Freems88/esp32-eink-clock/Counting_Seconds.ino

#include "secrets.h"
#include "bitmaps.h"
#include "weather_icons.h"
#include <GxEPD2_BW.h>
#include <U8g2_for_Adafruit_GFX.h>
#include <WiFi.h>
#include <HTTPClient.h>
#include <ArduinoJson.h>
#include <time.h>
#include <SPI.h>
#include <driver/gpio.h>

// ── Display definitions ────────────────────────────────────────────────────
// Board: FireBeetle 2 ESP32-C5 (DFR1222) — see MIGRATION.md
// Shared SPI: SCK=23, MOSI=24 (hardware SPI), DC=10, RST=9
//
// Every panel gets a real BUSY line. GPIO11/12 are free because the C5 uses
// native USB CDC for Serial (UART0 unused); GPIO25/MISO is free because e-ink
// is write-only. GPIO7 and 25 are strapping pins but NOT boot-mode ones (only
// 26/27/28 set boot mode) — and BUSY is an input, so we never drive them.
// They're assigned to DD and MMM, the two panels that refresh least often.
//
//                                  CS   BUSY   BUSY silkscreen
// display1 = 4"   MM (minutes)      8     6     6/D12/LP_SDA
// display2 = 4"   HH (hours)        5    11     11/TX
// display3 = 4"   DD (day)          4    25     25/MI   (strapping, SDIO)
// display4 = 4"   MMM (month)       3     7     7/D11/LP_SCL (strapping)
// display5 = 7"   DDDE / weather    2    12     12/RX
//
// Left alone: 15 (onboard LED), 1 (battery ADC), 26/27/28 (boot-mode strapping)

const int PIN_SCK  = 23;
const int PIN_MOSI = 24;
// GPIO25 is the board's MISO but e-ink never reads back, so it serves as display3 BUSY

GxEPD2_BW<GxEPD2_420_GDEY042T81, GxEPD2_420_GDEY042T81::HEIGHT / 4> display1(GxEPD2_420_GDEY042T81(/*CS=*/ 8, /*DC=*/ 10, /*RST=*/ 9, /*BUSY=*/ 6));
GxEPD2_BW<GxEPD2_420_GDEY042T81, GxEPD2_420_GDEY042T81::HEIGHT / 4> display2(GxEPD2_420_GDEY042T81(/*CS=*/ 5, /*DC=*/ 10, /*RST=*/ 9, /*BUSY=*/ 11));
GxEPD2_BW<GxEPD2_420_GDEY042T81, GxEPD2_420_GDEY042T81::HEIGHT / 4> display3(GxEPD2_420_GDEY042T81(/*CS=*/ 4, /*DC=*/ 10, /*RST=*/ 9, /*BUSY=*/ 25));
GxEPD2_BW<GxEPD2_420_GDEY042T81, GxEPD2_420_GDEY042T81::HEIGHT / 4> display4(GxEPD2_420_GDEY042T81(/*CS=*/ 3, /*DC=*/ 10, /*RST=*/ 9, /*BUSY=*/ 7));
GxEPD2_BW<GxEPD2_750_GDEY075T7, GxEPD2_750_GDEY075T7::HEIGHT / 2>  display5(GxEPD2_750_GDEY075T7( /*CS=*/ 2, /*DC=*/ 10, /*RST=*/ 9, /*BUSY=*/ 12));

U8G2_FOR_ADAFRUIT_GFX u8g2Fonts;

const char* ssid     = WIFI_SSID;
const char* password = WIFI_PASSWORD;

// ── Weather helpers ────────────────────────────────────────────────────────

const char* weatherDescription(int code)
{
  if (code == 0)  return "Clear";
  if (code <= 3)  return "Partly Cloudy";
  if (code <= 48) return "Foggy";
  if (code <= 55) return "Drizzle";
  if (code <= 67) return "Rain";
  if (code <= 77) return "Snow";
  if (code <= 82) return "Showers";
  if (code <= 99) return "Thunderstorm";
  return "Unknown";
}

const char* windCardinal(int degrees)
{
  const char* directions[] = {
    "N","NNE","NE","ENE","E","ESE","SE","SSE",
    "S","SSW","SW","WSW","W","WNW","NW","NNW"
  };
  return directions[(int)((degrees + 11.25) / 22.5) % 16];
}

// ── Location (defined in secrets.h) ────────────────────────────────────────

const float LAT = WEATHER_LAT;
const float LON = WEATHER_LON;

// ── Bitmap dimensions ──────────────────────────────────────────────────────
// Digit bitmaps (display1, display2): two per panel side by side
const int DIGIT_BITMAP_WIDTH  = 200;
const int DIGIT_BITMAP_HEIGHT = 300;

// Day-of-week bitmaps (display5 upper half): full 7" panel width
const int DOW_BITMAP_WIDTH  = 800;
const int DOW_BITMAP_HEIGHT = 240;

// Month bitmaps (display4): full 4.2" panel width
const int MONTH_BITMAP_WIDTH  = 400;
const int MONTH_BITMAP_HEIGHT = 300;

// ── RTC memory (survives light sleep) ─────────────────────────────────────

RTC_DATA_ATTR int  lastMinute        = -1;
RTC_DATA_ATTR int  lastHour          = -1;
RTC_DATA_ATTR int  lastDay           = -1;
RTC_DATA_ATTR int  lastMonth         = -1;
RTC_DATA_ATTR int  lastSyncSlot      = -1;
RTC_DATA_ATTR int  updateCount       = 0;
RTC_DATA_ATTR bool lastWeatherValid  = false;
RTC_DATA_ATTR bool weatherChanged    = false;  // set after each sync, cleared after full refresh
RTC_DATA_ATTR bool batteryShutdown   = false;  // parked on low battery, waiting for charge
RTC_DATA_ATTR int    weatherRetriesLeft = 0;   // bounded next-minute retries after a failed fetch
RTC_DATA_ATTR time_t lastWeatherSync    = 0;   // when the last successful fetch happened

// Keep showing stale weather for up to 2h before declaring it unavailable
const time_t WEATHER_STALE_SECS = 2 * 3600;

RTC_DATA_ATTR int   weatherCode      = 0;
RTC_DATA_ATTR float rainSum          = 0;
RTC_DATA_ATTR float showersSum       = 0;
RTC_DATA_ATTR float snowfallSum      = 0;
RTC_DATA_ATTR float currentTemp      = 0;
RTC_DATA_ATTR float feelsLike        = 0;
RTC_DATA_ATTR float humidity         = 0;
RTC_DATA_ATTR float windSpeed        = 0;
RTC_DATA_ATTR int   windDirection    = 0;
RTC_DATA_ATTR float precipitation24h = 0;
RTC_DATA_ATTR float dayHigh          = 0;
RTC_DATA_ATTR float dayLow           = 0;
RTC_DATA_ATTR bool  weatherValid     = false;
RTC_DATA_ATTR bool  timeValid        = true;
RTC_DATA_ATTR char  weatherError[48] = "no attempt";
RTC_DATA_ATTR float pressure         = 0;
RTC_DATA_ATTR char  sunriseStr[6]    = "--:--";
RTC_DATA_ATTR char  sunsetStr[6]     = "--:--";

// ── Lookup tables ──────────────────────────────────────────────────────────

const char* dayNames[] = {
  "SUNDAY","MONDAY","TUESDAY","WEDNESDAY",
  "THURSDAY","FRIDAY","SATURDAY"
};

const char* monthNames[] = {
  "JAN","FEB","MAR","APR","MAY","JUN",
  "JUL","AUG","SEP","OCT","NOV","DEC"
};

const unsigned char* monthBitmaps[] = {
  epd_bitmap_VerdanaJAN, epd_bitmap_VerdanaFEB, epd_bitmap_VerdanaMAR,
  epd_bitmap_VerdanaAPR, epd_bitmap_VerdanaMAY, epd_bitmap_VerdanaJUN,
  epd_bitmap_VerdanaJUL, epd_bitmap_VerdanaAUG, epd_bitmap_VerdanaSEP,
  epd_bitmap_VerdanaOCT, epd_bitmap_VerdanaNOV, epd_bitmap_VerdanaDEC
};

// ── Day-of-week bitmap index ───────────────────────────────────────────────
// bitmaps.h allArray index by tm_wday (alphabetical order in new file):
// 14=FRI, 20=MON, 23=SAT, 25=SUN, 26=THURS, 27=TUES, 28=WED

int dowBitmapIndex(int tm_wday)
{
  const int indices[7] = {25, 20, 27, 28, 26, 14, 23}; // Sun=0 … Sat=6
  return indices[tm_wday];
}

// ── WiFi / NTP / Weather ───────────────────────────────────────────────────

bool fetchWeather()
{
  HTTPClient http;
  String url = String("https://api.open-meteo.com/v1/forecast?") +
    "latitude="  + String(LAT, 4) +
    "&longitude=" + String(LON, 4) +
    "&current=temperature_2m,apparent_temperature,relative_humidity_2m,"
               "wind_speed_10m,wind_direction_10m,weather_code,surface_pressure" +
    "&daily=temperature_2m_max,temperature_2m_min,precipitation_sum,"
            "rain_sum,showers_sum,snowfall_sum,sunrise,sunset" +
    "&timezone=auto&forecast_days=1";  // auto resolves tz from the coordinates

  http.begin(url);
  http.setTimeout(15000);  // TLS handshake can be slow; 8s was causing HTTP -1
  int httpCode = http.GET();
  if (httpCode != 200)
  {
    snprintf(weatherError, sizeof(weatherError), "HTTP %d  WiFi:%d", httpCode, WiFi.status());
    Serial.printf("Weather HTTP error: %d\n", httpCode);
    http.end();
    return false;
  }

  String payload = http.getString();
  http.end();

  DynamicJsonDocument doc(2048);
  if (deserializeJson(doc, payload))
  {
    snprintf(weatherError, sizeof(weatherError), "JSON parse  WiFi:%d", WiFi.status());
    Serial.println("JSON parse failed");
    return false;
  }

  currentTemp      = doc["current"]["temperature_2m"];
  feelsLike        = doc["current"]["apparent_temperature"];
  humidity         = doc["current"]["relative_humidity_2m"];
  windSpeed        = doc["current"]["wind_speed_10m"];
  windDirection    = doc["current"]["wind_direction_10m"];
  weatherCode      = doc["current"]["weather_code"];
  pressure         = doc["current"]["surface_pressure"];
  dayHigh          = doc["daily"]["temperature_2m_max"][0];
  dayLow           = doc["daily"]["temperature_2m_min"][0];
  precipitation24h = doc["daily"]["precipitation_sum"][0];
  rainSum          = doc["daily"]["rain_sum"][0];
  showersSum       = doc["daily"]["showers_sum"][0];
  snowfallSum      = doc["daily"]["snowfall_sum"][0];

  // Parse sunrise/sunset — Open-Meteo returns "YYYY-MM-DDTHH:MM", keep HH:MM
  const char* sr = doc["daily"]["sunrise"][0];
  const char* ss = doc["daily"]["sunset"][0];
  if (sr && strlen(sr) >= 16) strncpy(sunriseStr, sr + 11, 5), sunriseStr[5] = '\0';
  if (ss && strlen(ss) >= 16) strncpy(sunsetStr,  ss + 11, 5), sunsetStr[5]  = '\0';

  return true;
}

void showError(const char* msg)
{
  // display6 retired — errors logged to Serial only
  Serial.printf("ERROR: %s\n", msg);
}

bool connectSyncAndFetch()
{
  WiFi.mode(WIFI_STA);
  WiFi.begin(ssid, password);
  int attempts = 0;
  // Wait for association AND a valid DHCP address (not just layer-2 link)
  while (attempts < 20 &&
         (WiFi.status() != WL_CONNECTED ||
          WiFi.localIP() == IPAddress(0, 0, 0, 0)))
  {
    delay(500);
    attempts++;
  }
  Serial.printf("WiFi up after %d attempts, IP: %s\n",
                attempts, WiFi.localIP().toString().c_str());

  if (WiFi.status() != WL_CONNECTED)
  {
    String reason = "wifi failed: ";
    switch (WiFi.status())
    {
      case WL_NO_SSID_AVAIL:  reason += "no network found"; break;
      case WL_CONNECT_FAILED: reason += "wrong password";   break;
      case WL_DISCONNECTED:   reason += "disconnected";     break;
      default:                reason += String(WiFi.status()); break;
    }
    WiFi.disconnect(true);
    WiFi.mode(WIFI_OFF);
    showError(reason.c_str());
    return false;
  }

  // configTzTime (not configTime) — plain configTime(0,0,...) overwrites TZ with UTC
  configTzTime(CLOCK_TZ, "time.google.com", "time.cloudflare.com", "pool.ntp.org");

  struct tm timeinfo;
  int ntpAttempts = 0;
  while (!getLocalTime(&timeinfo) && ntpAttempts < 5)
  {
    ntpAttempts++;
    Serial.printf("NTP attempt %d of 5\n", ntpAttempts);
    showError(("NTP sync " + String(ntpAttempts) + "/5").c_str());
    delay(2000);
  }

  if (!getLocalTime(&timeinfo))
  {
    timeValid = false;
    showError("NTP failed");
  }
  else
  {
    timeValid = true;
    Serial.printf("Synced to: %02d:%02d:%02d\n",
      timeinfo.tm_hour, timeinfo.tm_min, timeinfo.tm_sec);
  }

  bool fetched = false;
  for (int attempt = 1; attempt <= 3 && !fetched; attempt++)
  {
    fetched = fetchWeather();
    if (!fetched)
    {
      Serial.printf("Weather fetch failed (attempt %d/3)\n", attempt);
      if (attempt < 3) delay(2000 * attempt);  // 2s then 4s backoff
    }
  }
  if (fetched)
  {
    weatherValid    = true;
    lastWeatherSync = time(nullptr);
  }
  else if (weatherValid && time(nullptr) - lastWeatherSync > WEATHER_STALE_SECS)
  {
    // On failure, keep showing the last good data; only surface
    // "Weather unavailable" once it has gone truly stale
    weatherValid = false;
  }

  WiFi.disconnect(true);
  WiFi.mode(WIFI_OFF);
  Serial.println("WiFi off");
  return true;
}

// ── Display rendering ──────────────────────────────────────────────────────

// Display 2 (right): HH — hours in 12hr format, two digit bitmaps side by side
void showHH(struct tm timeinfo, bool fullRefresh)
{
  int hour12 = timeinfo.tm_hour % 12;
  if (hour12 == 0) hour12 = 12;

  display2.setRotation(0);
  if (fullRefresh) { display2.clearScreen(); display2.setFullWindow(); }
  else display2.setPartialWindow(0, 0, display2.width(), display2.height());

  display2.firstPage();
  do
  {
    display2.fillScreen(GxEPD_WHITE);
    display2.drawBitmap(0, 0,
      epd_bitmap_allArray[hour12 / 10],
      DIGIT_BITMAP_WIDTH, DIGIT_BITMAP_HEIGHT, GxEPD_BLACK);
    display2.drawBitmap(DIGIT_BITMAP_WIDTH, 0,
      epd_bitmap_allArray[hour12 % 10],
      DIGIT_BITMAP_WIDTH, DIGIT_BITMAP_HEIGHT, GxEPD_BLACK);
  }
  while (display2.nextPage());
}

// Display 1 (left): MM — minutes, two digit bitmaps side by side
// AM/PM overlaid in the lower-right corner (negative space of units digit)
void showMM(struct tm timeinfo, bool fullRefresh)
{
  const char* ampm = timeinfo.tm_hour < 12 ? "AM" : "PM";

  display1.setRotation(0);
  if (fullRefresh) { display1.clearScreen(); display1.setFullWindow(); }
  else display1.setPartialWindow(0, 0, display1.width(), display1.height());

  // measure AM/PM text width before entering the loop
  u8g2Fonts.begin(display1);
  u8g2Fonts.setFontMode(1);
  u8g2Fonts.setFont(u8g2_font_fub30_tf);
  int16_t ampmW = u8g2Fonts.getUTF8Width(ampm);
  int16_t ampmX = display1.width() - ampmW - 16;
  int16_t ampmY = display1.height() - 16;

  display1.firstPage();
  do
  {
    display1.fillScreen(GxEPD_WHITE);
    display1.drawBitmap(0, 0,
      epd_bitmap_allArray[timeinfo.tm_min / 10],
      DIGIT_BITMAP_WIDTH, DIGIT_BITMAP_HEIGHT, GxEPD_BLACK);
    display1.drawBitmap(DIGIT_BITMAP_WIDTH, 0,
      epd_bitmap_allArray[timeinfo.tm_min % 10],
      DIGIT_BITMAP_WIDTH, DIGIT_BITMAP_HEIGHT, GxEPD_BLACK);

    // bind u8g2 AFTER drawBitmap calls — avoids GFX state reset
    u8g2Fonts.begin(display1);
    u8g2Fonts.setFontMode(1);
    u8g2Fonts.setFont(u8g2_font_fub30_tf);
    u8g2Fonts.setForegroundColor(GxEPD_WHITE);
    u8g2Fonts.setBackgroundColor(GxEPD_BLACK);

    u8g2Fonts.setCursor(ampmX, ampmY);
    u8g2Fonts.print(ampm);
  }
  while (display1.nextPage());
}

// Maps WMO weather code + hour to weatherIcons[] index
// 0=clear day, 1=clear night, 2=clouds, 3=rain, 4=thunderstorm, 5=snow, 6=mist
int weatherIconIndex(int code, int hour)
{
  bool isDay = (hour >= 6 && hour < 20);
  if (code == 0)              return isDay ? 0 : 1;
  if (code <= 3)              return 2;
  if (code <= 48)             return 6;
  if (code <= 67 || (code >= 80 && code <= 82)) return 3;
  if (code <= 77 || (code >= 85 && code <= 86)) return 5;
  return 4;  // thunderstorm
}

// Nearest-neighbor scaled bitmap draw for display5 (white pixels on black bg)
static void drawScaledIcon(int x, int y, const uint8_t* bmp, int dstW, int dstH)
{
  for (int dy = 0; dy < dstH; dy++) {
    int sy = dy * 128 / dstH;
    for (int dx = 0; dx < dstW; dx++) {
      int sx = dx * 128 / dstW;
      int bit = sy * 128 + sx;
      if (pgm_read_byte(bmp + bit / 8) & (0x80 >> (bit % 8)))
        display5.drawPixel(x + dx, y + dy, GxEPD_WHITE);
    }
  }
}


// Teardrop water-drop icon, tip pointing up, circle centre at (cx, cy)
static void drawWaterDrop(int cx, int cy, int r)
{
  display5.fillCircle(cx, cy, r, GxEPD_WHITE);
  display5.fillTriangle(cx, cy - r - r, cx - r, cy, cx + r, cy, GxEPD_WHITE);
}

// Display 3: DD — day of month with leading zero, two digit bitmaps side by side
void showDD(struct tm timeinfo, bool fullRefresh)
{
  int day = timeinfo.tm_mday;  // 1–31; leading-zero handled by integer split

  display3.setRotation(0);
  if (fullRefresh) { display3.clearScreen(); display3.setFullWindow(); }
  else display3.setPartialWindow(0, 0, display3.width(), display3.height());

  display3.firstPage();
  do
  {
    display3.fillScreen(GxEPD_WHITE);
    display3.drawBitmap(0, 0,
      epd_bitmap_allArray[day / 10],
      DIGIT_BITMAP_WIDTH, DIGIT_BITMAP_HEIGHT, GxEPD_BLACK);
    display3.drawBitmap(DIGIT_BITMAP_WIDTH, 0,
      epd_bitmap_allArray[day % 10],
      DIGIT_BITMAP_WIDTH, DIGIT_BITMAP_HEIGHT, GxEPD_BLACK);
  }
  while (display3.nextPage());
}

// Display 4: MMM — full-panel month bitmap (400×300), same pattern as digit displays
void showMMM(struct tm timeinfo, bool fullRefresh)
{
  display4.setRotation(0);
  if (fullRefresh) { display4.clearScreen(); display4.setFullWindow(); }
  else display4.setPartialWindow(0, 0, display4.width(), display4.height());

  display4.firstPage();
  do
  {
    display4.fillScreen(GxEPD_WHITE);
    display4.drawBitmap(0, 0,
      monthBitmaps[timeinfo.tm_mon],
      MONTH_BITMAP_WIDTH, MONTH_BITMAP_HEIGHT, GxEPD_BLACK);
  }
  while (display4.nextPage());
}

// Battery voltage on GPIO1. analogReadMilliVolts applies the chip's factory ADC
// calibration — much more accurate than converting raw counts by hand.
// Divider measured at 2.015 (multimeter 3.96V vs 1.965V at the ADC); nominally
// a 2:1 divider, the 0.8% is resistor tolerance.
const float BATT_DIVIDER = 2.015;

// Park the clock well above the cell's protection trip (~3.0V) — past the knee
// of the LiPo curve voltage collapses fast, so 3.55V leaves real margin.
// Recovery is higher than shutdown so a charging cell can't oscillate the state.
const float    BATT_SHUTDOWN = 3.55;
// 100mV of hysteresis is plenty: parked draw is tiny, so load-removal rebound is
// only ~3mV and slow relaxation ~20-50mV. Higher would just mean hours of
// "BATTERY EMPTY" while charging, since 3.80V resting is ~50% state of charge.
const float    BATT_RECOVER  = 3.65;
const uint64_t BATT_CHECK_US = 30ULL * 60 * 1000000;  // recheck every 30 min while parked

float battVolts()
{
  uint32_t sum = 0;
  for (int i = 0; i < 8; i++) sum += analogReadMilliVolts(1);  // ADC is noisy — average
  return (sum / 8) * BATT_DIVIDER / 1000.0;
}

// Display 5: DDDE
// Upper half: day-of-week bitmap
// Lower half: col1=weather icon+description, col2=temp/feels/HL, col3=wind text
void showDDDE(struct tm timeinfo, bool fullRefresh)
{
  display5.setRotation(0);
  if (fullRefresh) { display5.clearScreen(); display5.setFullWindow(); }
  else display5.setPartialWindow(0, 0, display5.width(), display5.height());

  const int W      = display5.width();        // 800
  const int TOP    = DOW_BITMAP_HEIGHT;       // 240
  const int ZONE_H = display5.height() - TOP; // 240

  // ── equal-thirds columns ─────────────────────────────────────────────────
  const int ICON_W     = 267;   // col1 right edge
  const int COL_CENTER = 400;   // col2 centre
  const int COL1_CTR   = 133;   // col1 centre
  const int COL3_CTR   = 667;   // col3 centre

  // ── col1: weather icon — 200px, shifted up slightly ──────────────────────
  const int ICON_DST = 200;
  const int ICON_X   = (ICON_W - ICON_DST) / 2;  // 33
  const int ICON_Y   = TOP + 18;                  // 8px higher than before

  // ── col2: temperature baselines ──────────────────────────────────────────
  const int C_TEMP = TOP + 98;    // logisoso78 top lands at ~260, clear of zone edge
  const int C_FEEL = TOP + 138;   // fub25, ~40px below temp baseline
  const int C_HL   = TOP + 200;   // fub25, dropped lower to use available space

  int16_t dowX = (W - DOW_BITMAP_WIDTH) / 2;

  // Sample once, outside the page loop, so the value is identical across pages
  char battBuf[16];
  {
    float v = battVolts();
    sprintf(battBuf, "%.2fV", v);
    Serial.printf("Battery: %s\n", battBuf);
  }

  display5.firstPage();
  do
  {
    display5.fillScreen(GxEPD_WHITE);

    // ── upper half: day-of-week bitmap ────────────────────────────────────
    display5.drawBitmap(dowX, 0,
      epd_bitmap_allArray[dowBitmapIndex(timeinfo.tm_wday)],
      DOW_BITMAP_WIDTH, DOW_BITMAP_HEIGHT, GxEPD_BLACK);

    // ── lower half: black background ──────────────────────────────────────
    display5.fillRect(0, TOP, W, ZONE_H, GxEPD_BLACK);

    u8g2Fonts.begin(display5);
    u8g2Fonts.setFontMode(1);
    u8g2Fonts.setForegroundColor(GxEPD_WHITE);
    u8g2Fonts.setBackgroundColor(GxEPD_BLACK);

    if (!weatherValid)
    {
      u8g2Fonts.setFont(u8g2_font_fub20_tf);
      u8g2Fonts.setCursor(COL_CENTER - u8g2Fonts.getUTF8Width("Weather unavailable") / 2, C_TEMP);
      u8g2Fonts.print("Weather unavailable");
      u8g2Fonts.setCursor(COL_CENTER - u8g2Fonts.getUTF8Width(weatherError) / 2, C_FEEL);
      u8g2Fonts.print(weatherError);
    }
    else
    {
      // ── col1: condition description ───────────────────────────────────────
      u8g2Fonts.setFont(u8g2_font_fub20_tf);
      {
        const char* desc = weatherDescription(weatherCode);
        u8g2Fonts.setCursor(COL1_CTR - u8g2Fonts.getUTF8Width(desc) / 2, TOP + 30);
        u8g2Fonts.print(desc);
      }

      // ── col1: weather icon scaled 128→200px ──────────────────────────────
      drawScaledIcon(ICON_X, ICON_Y,
        weatherIcons[weatherIconIndex(weatherCode, timeinfo.tm_hour)],
        ICON_DST, ICON_DST);

      u8g2Fonts.begin(display5);
      u8g2Fonts.setFontMode(1);
      u8g2Fonts.setForegroundColor(GxEPD_WHITE);
      u8g2Fonts.setBackgroundColor(GxEPD_BLACK);

      // ── col2: temperature ─────────────────────────────────────────────────
      char numStr[8];
      sprintf(numStr, "%.0f", currentTemp);
      const char* unitStr = "\xc2\xb0""C";
      u8g2Fonts.setFont(u8g2_font_logisoso78_tn);
      int16_t numW  = u8g2Fonts.getUTF8Width(numStr);
      u8g2Fonts.setFont(u8g2_font_fub30_tf);
      int16_t unitW = u8g2Fonts.getUTF8Width(unitStr);
      int16_t tempX = COL_CENTER - (numW + unitW) / 2;
      u8g2Fonts.setFont(u8g2_font_logisoso78_tn);
      u8g2Fonts.setCursor(tempX, C_TEMP);
      u8g2Fonts.print(numStr);
      u8g2Fonts.setFont(u8g2_font_fub30_tf);
      u8g2Fonts.setCursor(tempX + numW, C_TEMP - 22);
      u8g2Fonts.print(unitStr);

      // ── col2: feels like ──────────────────────────────────────────────────
      u8g2Fonts.setFont(u8g2_font_fub25_tf);
      char feelsBuf[24];
      sprintf(feelsBuf, "feels like %.0f\xc2\xb0""C", feelsLike);
      u8g2Fonts.setCursor(COL_CENTER - u8g2Fonts.getUTF8Width(feelsBuf) / 2, C_FEEL);
      u8g2Fonts.print(feelsBuf);

      // ── col2: high / low ──────────────────────────────────────────────────
      u8g2Fonts.setFont(u8g2_font_fub25_tf);
      char hlBuf[24];
      sprintf(hlBuf, "H:%.0f\xc2\xb0  L:%.0f\xc2\xb0""C", dayHigh, dayLow);
      u8g2Fonts.setCursor(COL_CENTER - u8g2Fonts.getUTF8Width(hlBuf) / 2, C_HL);
      u8g2Fonts.print(hlBuf);

      // ── col3: wind direction + speed ─────────────────────────────────────
      // direction at TOP+43, speed baseline at TOP+138 (aligns with C_FEEL)
      const char* cardDir = windCardinal(windDirection);
      u8g2Fonts.setFont(u8g2_font_fub20_tf);
      u8g2Fonts.setCursor(COL3_CTR - u8g2Fonts.getUTF8Width(cardDir) / 2, TOP + 43);
      u8g2Fonts.print(cardDir);

      char speedBuf[8];
      sprintf(speedBuf, "%.0f", windSpeed);
      u8g2Fonts.setFont(u8g2_font_logisoso78_tn);
      u8g2Fonts.setCursor(COL3_CTR - u8g2Fonts.getUTF8Width(speedBuf) / 2, TOP + 138);
      u8g2Fonts.print(speedBuf);

      u8g2Fonts.setFont(u8g2_font_fub20_tf);
      u8g2Fonts.setCursor(COL3_CTR - u8g2Fonts.getUTF8Width("km/h") / 2, TOP + 183);
      u8g2Fonts.print("km/h");
    }

    // Battery readout, lower right corner
    u8g2Fonts.setFont(u8g2_font_fub11_tf);
    u8g2Fonts.setCursor(W - 8 - u8g2Fonts.getUTF8Width(battBuf), display5.height() - 8);
    u8g2Fonts.print(battBuf);
  }
  while (display5.nextPage());
}



// Parks the clock on low battery. Blanks the time/date panels so nobody reads a
// stale clock, and leaves a charge notice where the weather normally sits.
// E-ink holds all of this at zero power, so it stays legible while the board sleeps.
void showBatteryShutdown(struct tm* timeinfo, float volts)
{
  display1.clearScreen();
  display2.clearScreen();
  display3.clearScreen();
  display4.clearScreen();

  const int W      = display5.width();
  const int TOP    = DOW_BITMAP_HEIGHT;
  const int ZONE_H = display5.height() - TOP;
  int16_t dowX = (W - DOW_BITMAP_WIDTH) / 2;

  char voltBuf[16];
  sprintf(voltBuf, "%.2fV", volts);

  display5.setRotation(0);
  display5.setFullWindow();
  display5.firstPage();
  do
  {
    display5.fillScreen(GxEPD_WHITE);

    // Day of week stays if the time is known — gives the notice some context
    if (timeinfo)
      display5.drawBitmap(dowX, 0,
        epd_bitmap_allArray[dowBitmapIndex(timeinfo->tm_wday)],
        DOW_BITMAP_WIDTH, DOW_BITMAP_HEIGHT, GxEPD_BLACK);

    display5.fillRect(0, TOP, W, ZONE_H, GxEPD_BLACK);

    u8g2Fonts.begin(display5);
    u8g2Fonts.setFontMode(1);
    u8g2Fonts.setForegroundColor(GxEPD_WHITE);
    u8g2Fonts.setBackgroundColor(GxEPD_BLACK);

    const char* line1 = "BATTERY EMPTY";
    u8g2Fonts.setFont(u8g2_font_fub30_tf);
    u8g2Fonts.setCursor((W - u8g2Fonts.getUTF8Width(line1)) / 2, TOP + 85);
    u8g2Fonts.print(line1);

    const char* line2 = "Connect USB-C to charge";
    u8g2Fonts.setFont(u8g2_font_fub20_tf);
    u8g2Fonts.setCursor((W - u8g2Fonts.getUTF8Width(line2)) / 2, TOP + 135);
    u8g2Fonts.print(line2);

    u8g2Fonts.setFont(u8g2_font_fub20_tf);
    u8g2Fonts.setCursor((W - u8g2Fonts.getUTF8Width(voltBuf)) / 2, TOP + 190);
    u8g2Fonts.print(voltBuf);
  }
  while (display5.nextPage());
}

// ── Deep sleep ─────────────────────────────────────────────────────────────
// Deep sleep reboots into setup() on every wake, so all clock logic lives
// there and loop() is never reached. State persists via RTC_DATA_ATTR.

void goToSleep(uint64_t microseconds)
{
  Serial.printf("Sleeping %.1f s\n", microseconds / 1000000.0);
  Serial.flush();  // deep sleep cuts UART mid-buffer otherwise

  // Hold shared RST (GPIO9) high through deep sleep — a floating reset line
  // could glitch the hibernated displays and corrupt their retained frame state
  // TODO(C5 migration): verify GPIO9 is hold-capable on the C5, and find the
  // correct replacement for gpio_deep_sleep_hold_en() (not exposed on this
  // core). Until then the hold may not persist through sleep — see MIGRATION.md
  gpio_hold_en(GPIO_NUM_9);

  esp_sleep_enable_timer_wakeup(microseconds);
  esp_deep_sleep_start();
}

// ── Setup — runs on every wake ─────────────────────────────────────────────

void setup()
{
  Serial.begin(115200);

  // Env vars don't survive deep sleep — TZ must be set on every boot
  // or getLocalTime() renders UTC between NTP syncs
  setenv("TZ", CLOCK_TZ, 1);
  tzset();

  // Release the RST hold from the previous sleep so GxEPD2 can drive the pin
  gpio_hold_dis(GPIO_NUM_9);

  // Bind hardware SPI to the C5's pins before any display init.
  // MISO passed as -1: e-ink never reads back, and GPIO25 is display3's BUSY.
  SPI.begin(PIN_SCK, -1, PIN_MOSI, -1);

  // Battery is read first, before WiFi or any refresh loads the rail and drags
  // the reading low. Cheap enough (a few ms) to do on every single wake.
  float volts = battVolts();
  Serial.printf("Battery: %.2fV\n", volts);

  if (batteryShutdown)
  {
    if (volts < BATT_RECOVER)
    {
      // Still flat. Straight back to sleep without even initialising the
      // displays — the notice is already on screen and e-ink holds it.
      Serial.println("Still parked on low battery");
      goToSleep(BATT_CHECK_US);
    }
    // Charged enough to resume. Force a full redraw of everything, since the
    // time/date panels were blanked and their cached values are meaningless.
    Serial.println("Battery recovered — resuming");
    batteryShutdown = false;
    lastMinute = -1;
    lastHour   = -1;
    lastDay    = -1;
    lastMonth  = -1;
  }

  // Timer wake = normal minute tick; anything else = cold boot / reset
  bool coldBoot = (esp_sleep_get_wakeup_cause() != ESP_SLEEP_WAKEUP_TIMER);
  Serial.printf("Wake: %s (reset reason %d)\n",
                coldBoot ? "COLD BOOT" : "timer", esp_reset_reason());

  // Shared RST: pulse only on cold boot (resets all panels at once).
  // On timer wakes init via SPI only, preserving controller frame state
  // so partial refresh keeps working
  display1.init(115200, coldBoot, 2, false);
  display2.init(115200, false, 2, false);
  display3.init(115200, false, 2, false);
  display4.init(115200, false, 2, false);
  display5.init(115200, false, 2, false);

  // Below the floor: park before the rail sags far enough to brown out mid-refresh.
  // Checked ahead of the WiFi sync so a flat cell never powers up the radio.
  if (volts < BATT_SHUTDOWN)
  {
    Serial.printf("Battery critical (%.2fV) — parking\n", volts);
    batteryShutdown = true;
    struct tm shutdownTime;
    bool haveTime = getLocalTime(&shutdownTime, 100);  // short timeout: RTC or nothing
    showBatteryShutdown(haveTime ? &shutdownTime : nullptr, volts);
    hibernateDisplays();
    goToSleep(BATT_CHECK_US);
  }

  bool syncedOnBoot = false;
  if (coldBoot) syncedOnBoot = connectSyncAndFetch();

  struct tm timeinfo;
  if (!getLocalTime(&timeinfo))
  {
    Serial.println("Failed to get local time");
    timeValid = false;
    showError("time lost - resyncing");
    bool resynced = coldBoot ? false : connectSyncAndFetch();
    if (!resynced || !getLocalTime(&timeinfo))
    {
      showError("sync failed - sleep 5m");
      hibernateDisplays();
      goToSleep(5ULL * 60 * 1000000);
    }
  }

  int currentMinute = timeinfo.tm_min;
  int currentHour   = timeinfo.tm_hour;

  bool firstBoot     = (lastMinute == -1);   // force full refresh on cold start
  bool minuteChanged = (currentMinute != lastMinute);
  bool hourChanged   = (currentHour != lastHour);

  // ── time displays first — never delayed by radio work ────────────────────
  if (minuteChanged)
  {
    Serial.printf("Drawing %02d:%02d\n", currentHour, currentMinute);
    showHH(timeinfo, firstBoot || hourChanged);
    showMM(timeinfo, firstBoot || (timeinfo.tm_min % 10 == 0));

    // DD and MMM only refresh when their value actually changes
    if (timeinfo.tm_mday != lastDay)   showDD(timeinfo, true);
    if (timeinfo.tm_mon  != lastMonth) showMMM(timeinfo, true);

    lastMinute = currentMinute;
    lastHour   = currentHour;
    lastDay    = timeinfo.tm_mday;
    lastMonth  = timeinfo.tm_mon;
    updateCount++;
  }

  // ── radio: weather sync every 30 minutes ─────────────────────────────────
  int currentSlot = timeinfo.tm_hour * 100 + (timeinfo.tm_min / 30) * 30;
  if (syncedOnBoot)
  {
    // Cold boot already synced before time was known — just mark the slot
    lastSyncSlot       = currentSlot;
    weatherChanged     = weatherValid;
    weatherRetriesLeft = weatherValid ? 0 : 2;
  }
  else if (currentSlot != lastSyncSlot)
  {
    time_t before = lastWeatherSync;
    if (connectSyncAndFetch())
    {
      lastSyncSlot = currentSlot;
      bool fetchOk = (lastWeatherSync != before);
      weatherChanged     = fetchOk;      // full DDDE refresh only when data changed
      weatherRetriesLeft = fetchOk ? 0 : 2;  // arm bounded next-minute retries
    }
  }
  else if (weatherRetriesLeft > 0)
  {
    // Weather failed at the last slot despite WiFi being up — retry on this
    // minute wake, at most twice, then give up until the next slot
    weatherRetriesLeft--;
    time_t before = lastWeatherSync;
    if (connectSyncAndFetch() && lastWeatherSync != before)
    {
      weatherChanged     = true;
      weatherRetriesLeft = 0;
    }
  }

  // ── DDDE last — consumes whatever the sync produced ──────────────────────
  // Only has content that changes on the hour, after a weather sync, or when
  // weather valid state changes — no point refreshing every minute
  bool dddeNeeded = firstBoot || hourChanged || weatherChanged
                              || (weatherValid != lastWeatherValid);
  if (dddeNeeded)
  {
    Serial.println("Drawing DDDE");
    showDDDE(timeinfo, true);  // always full refresh when called
  }

  lastWeatherValid = weatherValid;
  weatherChanged   = false;

  // Hibernate unconditionally — displays were woken by init() above
  // regardless of whether anything was drawn this cycle
  hibernateDisplays();

  getLocalTime(&timeinfo);  // re-read: display refreshes take several seconds
  int secondsUntilNextMinute = 60 - timeinfo.tm_sec;
  // +250ms pad so we land just past the minute boundary, not just before it
  goToSleep(secondsUntilNextMinute * 1000000ULL + 250000);
}

void hibernateDisplays()
{
  // Saves ~40mA continuous draw; image is retained in pixel RAM
  display1.hibernate();
  display2.hibernate();
  display3.hibernate();
  display4.hibernate();
  display5.hibernate();
}

// ── Loop — never reached: deep sleep reboots into setup() ─────────────────

void loop() {}
