Freems88/esp32-eink-clock/(commit log)

2026-06-20 Add Printables link to README
2026-06-24 Fix hibernate wake (no RST), force full refresh on cold boot
    [Counting_Seconds.ino]
2026-06-24 Full refresh DDDE on weather valid state change to prevent ghosting
    [Counting_Seconds.ino]
2026-07-03 Fix cold boot showing UTC: configTime was clobbering TZ, use configTzTime
    [Counting_Seconds.ino]
2026-07-31 Migrate to FireBeetle 2 ESP32-C5 (DFR1222)
    Elegoo devkit idled at ~25mA regardless of sleep mode (regulator, USB-UART
    chip, power LED all upstream of the ESP32 sleep domain), capping runtime at
    ~9 days. FireBeetle 2 is battery-first with onboard LiPo charging.
    - Remap all pins for the C5: SCK=23, MOSI=24, DC=10, RST=9; CS 8/5/4/3/2 and
    dedicated BUSY 6/11/25/7/12
    - Explicit SPI.begin() with MISO=-1 (e-ink is write-only; GPIO25 serves as
    display3 BUSY)
    - Add MIGRATION.md: wiring, IDE settings, and board gotchas
    - Update README for the new board and pinout
    All five displays verified working.
2026-07-31 Add calibrated battery voltage readout on GPIO1
2026-08-03 README: add silkscreen labels to pin tables, note 3V3_C trap
2026-09-24 Add low-battery shutdown with auto-recovery
    Reads battery every wake, before WiFi or refresh loads the rail. Below
    3.55V: blanks the time/date panels, leaves a charge notice on DDDE, and
    sleeps in 30-minute intervals until 3.80V brings it back.
2026-09-24 Lower battery recovery threshold to 3.65V
    3.80V resting is ~50% state of charge - roughly 4000mAh at the board's
    0.5A charge rate, so the clock would sit parked for hours after being
    plugged in. Parked draw is tiny, so 100mV of hysteresis is ample.
